rlimaverde-commits/haste-scanbody/stl/haste_B_quadrados_15mm_L3.5_fenda0.6.stl

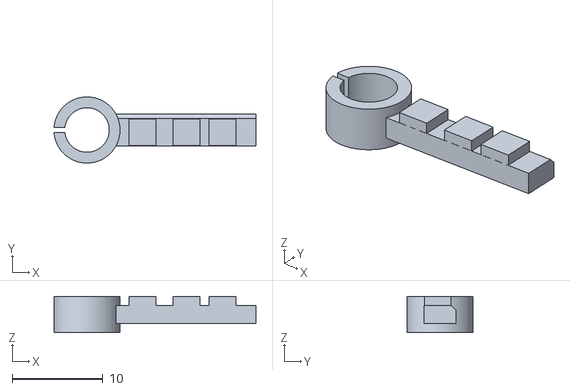
[picture p2: CAD file, 2026-09-30]
stl/haste_B_quadrados_15mm_L3.5_fenda0.6.stl
22.3 x 7.30 x 4.00
