rlimaverde-commits/haste-scanbody/stl/haste_D_misto_21mm_L4.5_fenda0.6.stl

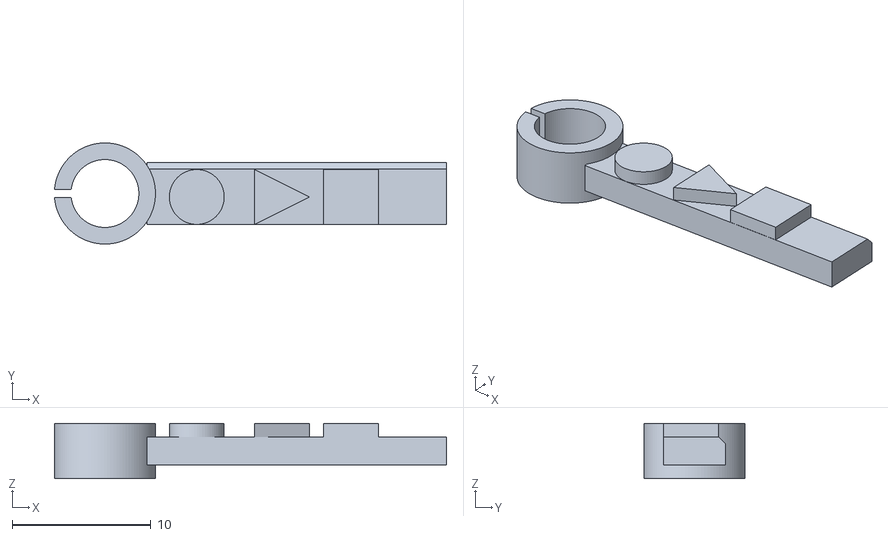
[picture p3: CAD file, 2026-09-30]
stl/haste_D_misto_21mm_L4.5_fenda0.6.stl
28.3 x 7.30 x 4.00
