rlimaverde-commits/haste-scanbody/stl/haste_C_cilindros_18mm_L4.0_fenda0.6.stl

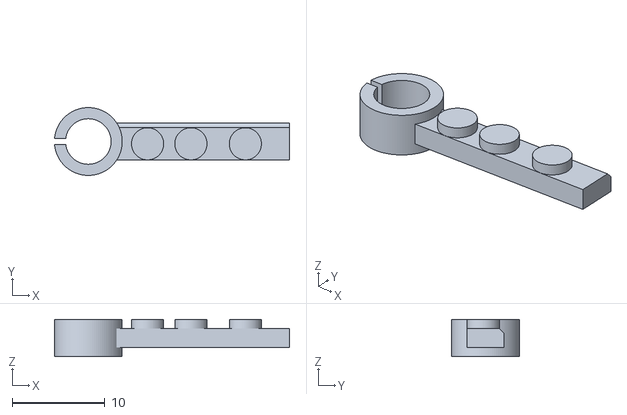
[picture p4: CAD file, 2026-09-30]
stl/haste_C_cilindros_18mm_L4.0_fenda0.6.stl
25.3 x 7.30 x 4.00
