rlimaverde-commits/haste-scanbody/stl/haste_A_triangulos_12mm_L3.0_fenda0.6.stl

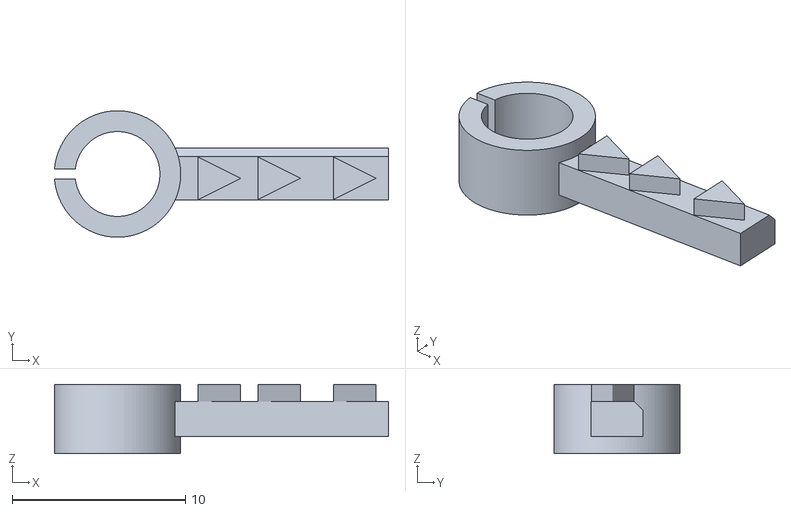
[picture p5: CAD file, 2026-09-30]
stl/haste_A_triangulos_12mm_L3.0_fenda0.6.stl
19.3 x 7.30 x 4.00
