rlimaverde-commits/haste-scanbody/(commit log)

2026-09-30 Versão inicial 1.0.0
    Hastes codificadas A–D, gerador paramétrico, instruções de impressão e uso,
    licenças (MIT / CC BY 4.0) e metadados de citação (CITATION.cff, .zenodo.json).
    Claude-Session: https://claude.ai/code/session_01Sv6UjAjqeDgzYPrzhR7Btw
    [haste_A_triangulos_12mm_L3.0_fenda0.6.stl, haste_B_quadrados_15mm_L3.5_fenda0.6.stl, haste_C_cilindros_18mm_L4.0_fenda0.6.stl, haste_D_misto_21mm_L4.5_fenda0.6.stl]
2026-10-27 Corrige sobrenome do autor para Osterne (#1)
    Atualiza CITATION.cff, .zenodo.json, README e licenças.
    Claude-Session: https://claude.ai/code/session_01H2vYovDeAmU8DvUXFzGa9Q
